TobyB-QLB/Z1013-Tang-Display/stl/README.md

# 3D-Gehäuse und Medien / 3D enclosure and media

[Deutsch](#deutsch) · [English](#english)

## Deutsch

Dieses Verzeichnis enthält die beiden STL-Dateien für das auf dem Foto gezeigte Z1013-Gehäuse sowie ein Foto und ein kurzes Video des aufgebauten Systems.

- [`Z1013_1.stl`](Z1013_1.stl) – erstes Gehäuseteil
- [`Z1013_2.stl`](Z1013_2.stl) – zweites Gehäuseteil
- [`z1013-tang-display.jpg`](z1013-tang-display.jpg) – für GitHub optimiertes Vorschaubild
- [`z1013-tang-display-innenaufbau.jpg`](z1013-tang-display-innenaufbau.jpg) – Innenansicht mit Display, Tang Nano 20K und Verkabelung
- [`IMG_0427.MOV`](IMG_0427.MOV) – Video des laufenden Aufbaus, etwa 40 MB

Die STL-Dateien werden in der Orientierung und mit den Einstellungen des jeweils verwendeten Slicers vorbereitet. Materialschrumpfung, Druckertoleranzen und die genaue Displaymontage können Anpassungen erfordern. Vor einem vollständigen Druck empfiehlt sich eine Kontrolle der Abmessungen und Steckerausschnitte im Slicer.

Das ursprüngliche HEIC-Foto bleibt lokal erhalten, wird aber nicht zusätzlich veröffentlicht, weil GitHub das daraus erzeugte JPEG direkt in der README anzeigen kann.

## English

This directory contains the two STL files for the enclosure shown in the photo, together with a photo and a short video of the assembled system.

- [`Z1013_1.stl`](Z1013_1.stl) – first enclosure part
- [`Z1013_2.stl`](Z1013_2.stl) – second enclosure part
- [`z1013-tang-display.jpg`](z1013-tang-display.jpg) – GitHub-optimized preview image
- [`z1013-tang-display-innenaufbau.jpg`](z1013-tang-display-innenaufbau.jpg) – internal view showing the display, Tang Nano 20K, and wiring
- [`IMG_0427.MOV`](IMG_0427.MOV) – video of the running system, approximately 40 MB

Prepare the STL orientation and print settings in the slicer used for your printer. Material shrinkage, printer tolerances, and the exact display mounting may require adjustments. Check dimensions and connector cutouts in the slicer before committing to a complete print.

The original HEIC photo remains in the local folder but is not published separately because GitHub can display the derived JPEG directly in the README.
