TobyB-QLB/Z1013-Tang-Display/stl/Z1013_2.stl

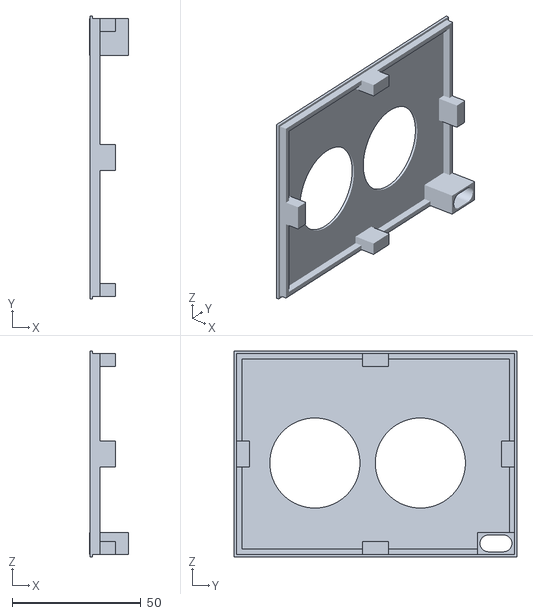
[picture p2: CAD file, 2026-10-25]
stl/Z1013_2.stl
15.0 x 110.0 x 80.0
