TobyB-QLB/Z1013-Tang-Display/stl/Z1013_1.stl

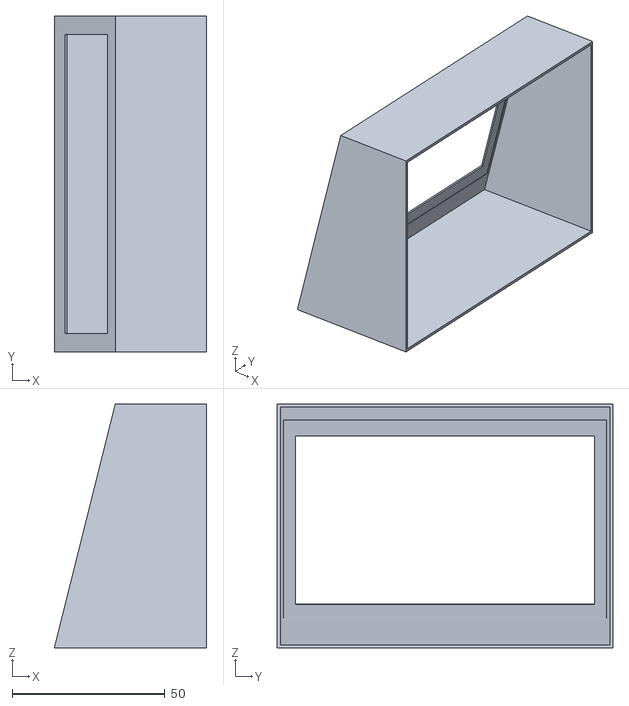
[picture p3: CAD file, 2026-10-25]
stl/Z1013_1.stl
50.0 x 110.0 x 80.0
