TobyB-QLB/Z1013-Tang-Display/stl/z1013-tang-display-innenaufbau.jpg

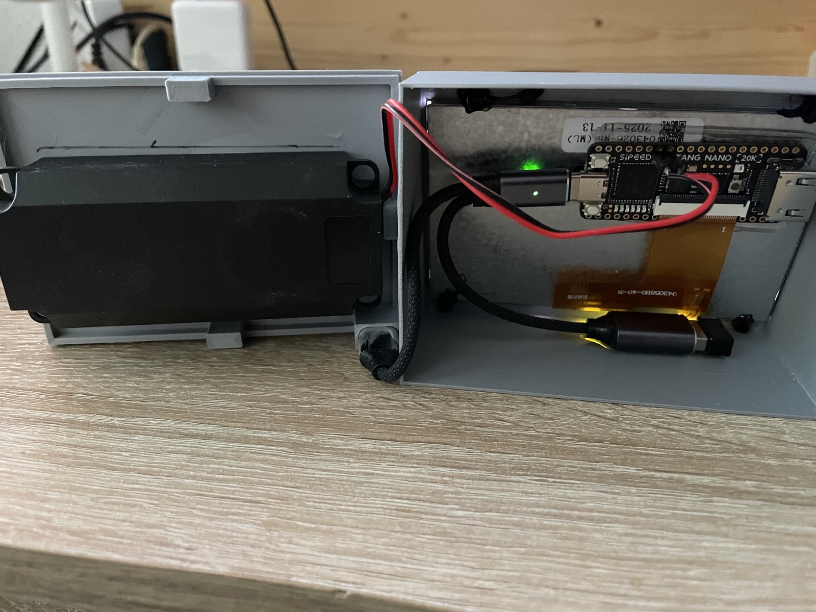
stl/z1013-tang-display-innenaufbau.jpg
