TobyB-QLB/Z1013-Tang-Display/src/color_ram.vhd

library IEEE;
use IEEE.STD_LOGIC_1164.ALL;
use IEEE.NUMERIC_STD.ALL;

-- 8 KiB dual-port colour attribute RAM.
--
-- Every byte corresponds one-to-one with a byte in the monochrome video RAM:
--   bits 3..0 = foreground colour
--   bits 7..4 = background colour
--
-- Port A is selected by the Z80 through the hidden colour-RAM bank. Port B is
-- read continuously in parallel with the original video RAM. The initial value
-- 0Fh means white foreground on black background.

entity color_ram is
    port (
        cpu_clk    : in  std_logic;
        cpu_addr   : in  std_logic_vector(12 downto 0);
        cpu_din    : in  std_logic_vector(7 downto 0);
        cpu_dout   : out std_logic_vector(7 downto 0);
        cpu_we     : in  std_logic;

        video_clk  : in  std_logic;
        video_addr : in  std_logic_vector(12 downto 0);
        video_dout : out std_logic_vector(7 downto 0)
    );
end entity color_ram;

-- Physical DPB blocks are inline: no dependency on another source file.
architecture gowin of color_ram is
 constant INITIAL_BYTE : natural := 15;

component DPB is
    GENERIC (
		BIT_WIDTH_0 : integer :=16; -- 1, 2, 4, 8, 16
		BIT_WIDTH_1 : integer :=16; -- 1, 2, 4, 8, 16
		READ_MODE0 : bit := '0'; -- 0: bypass mode; 1: pipeline mode
		READ_MODE1 : bit := '0'; -- 0: bypass mode; 1: pipeline mode
		WRITE_MODE0 : bit_vector := "00"; -- 00: normal mode; 01: write-through mode; 10: read-before-write mode
		WRITE_MODE1 : bit_vector := "00"; -- 00: normal mode; 01: write-through mode; 10: read-before-write mode
	    BLK_SEL_0 : bit_vector := "000";
	    BLK_SEL_1 : bit_vector := "000";
        RESET_MODE : string := "SYNC";--SYNC, ASYNC
		INIT_RAM_00 : bit_vector := X"0000000000000000000000000000000000000000000000000000000000000000";
		INIT_RAM_01 : bit_vector := X"0000000000000000000000000000000000000000000000000000000000000000";
		INIT_RAM_02 : bit_vector := X"0000000000000000000000000000000000000000000000000000000000000000";
		INIT_RAM_03 : bit_vector := X"0000000000000000000000000000000000000000000000000000000000000000";
		INIT_RAM_04 : bit_vector := X"0000000000000000000000000000000000000000000000000000000000000000";
		INIT_RAM_05 : bit_vector := X"0000000000000000000000000000000000000000000000000000000000000000";
		INIT_RAM_06 : bit_vector := X"0000000000000000000000000000000000000000000000000000000000000000";
		INIT_RAM_07 : bit_vector := X"0000000000000000000000000000000000000000000000000000000000000000";
		INIT_RAM_08 : bit_vector := X"0000000000000000000000000000000000000000000000000000000000000000";
		INIT_RAM_09 : bit_vector := X"0000000000000000000000000000000000000000000000000000000000000000";
		INIT_RAM_0A : bit_vector := X"0000000000000000000000000000000000000000000000000000000000000000";
		INIT_RAM_0B : bit_vector := X"0000000000000000000000000000000000000000000000000000000000000000";
		INIT_RAM_0C : bit_vector := X"0000000000000000000000000000000000000000000000000000000000000000";
		INIT_RAM_0D : bit_vector := X"0000000000000000000000000000000000000000000000000000000000000000";
		INIT_RAM_0E : bit_vector := X"0000000000000000000000000000000000000000000000000000000000000000";
		INIT_RAM_0F : bit_vector := X"0000000000000000000000000000000000000000000000000000000000000000";
		INIT_RAM_10 : bit_vector := X"0000000000000000000000000000000000000000000000000000000000000000";
		INIT_RAM_11 : bit_vector := X"0000000000000000000000000000000000000000000000000000000000000000";
		INIT_RAM_12 : bit_vector := X"0000000000000000000000000000000000000000000000000000000000000000";
		INIT_RAM_13 : bit_vector := X"0000000000000000000000000000000000000000000000000000000000000000";
		INIT_RAM_14 : bit_vector := X"0000000000000000000000000000000000000000000000000000000000000000";
		INIT_RAM_15 : bit_vector := X"0000000000000000000000000000000000000000000000000000000000000000";
		INIT_RAM_16 : bit_vector := X"0000000000000000000000000000000000000000000000000000000000000000";
		INIT_RAM_17 : bit_vector := X"0000000000000000000000000000000000000000000000000000000000000000";
		INIT_RAM_18 : bit_vector := X"0000000000000000000000000000000000000000000000000000000000000000";
		INIT_RAM_19 : bit_vector := X"0000000000000000000000000000000000000000000000000000000000000000";
		INIT_RAM_1A : bit_vector := X"0000000000000000000000000000000000000000000000000000000000000000";
		INIT_RAM_1B : bit_vector := X"0000000000000000000000000000000000000000000000000000000000000000";
		INIT_RAM_1C : bit_vector := X"0000000000000000000000000000000000000000000000000000000000000000";
		INIT_RAM_1D : bit_vector := X"0000000000000000000000000000000000000000000000000000000000000000";
		INIT_RAM_1E : bit_vector := X"0000000000000000000000000000000000000000000000000000000000000000";
		INIT_RAM_1F : bit_vector := X"0000000000000000000000000000000000000000000000000000000000000000";
		INIT_RAM_20 : bit_vector := X"0000000000000000000000000000000000000000000000000000000000000000";
		INIT_RAM_21 : bit_vector := X"0000000000000000000000000000000000000000000000000000000000000000";
		INIT_RAM_22 : bit_vector := X"0000000000000000000000000000000000000000000000000000000000000000";
		INIT_RAM_23 : bit_vector := X"0000000000000000000000000000000000000000000000000000000000000000";
		INIT_RAM_24 : bit_vector := X"0000000000000000000000000000000000000000000000000000000000000000";
		INIT_RAM_25 : bit_vector := X"0000000000000000000000000000000000000000000000000000000000000000";
		INIT_RAM_26 : bit_vector := X"0000000000000000000000000000000000000000000000000000000000000000";
		INIT_RAM_27 : bit_vector := X"0000000000000000000000000000000000000000000000000000000000000000";
		INIT_RAM_28 : bit_vector := X"0000000000000000000000000000000000000000000000000000000000000000";
		INIT_RAM_29 : bit_vector := X"0000000000000000000000000000000000000000000000000000000000000000";
		INIT_RAM_2A : bit_vector := X"0000000000000000000000000000000000000000000000000000000000000000";
		INIT_RAM_2B : bit_vector := X"0000000000000000000000000000000000000000000000000000000000000000";
		INIT_RAM_2C : bit_vector := X"0000000000000000000000000000000000000000000000000000000000000000";
		INIT_RAM_2D : bit_vector := X"0000000000000000000000000000000000000000000000000000000000000000";
		INIT_RAM_2E : bit_vector := X"0000000000000000000000000000000000000000000000000000000000000000";
		INIT_RAM_2F : bit_vector := X"0000000000000000000000000000000000000000000000000000000000000000";
		INIT_RAM_30 : bit_vector := X"0000000000000000000000000000000000000000000000000000000000000000";
		INIT_RAM_31 : bit_vector := X"0000000000000000000000000000000000000000000000000000000000000000";
		INIT_RAM_32 : bit_vector := X"0000000000000000000000000000000000000000000000000000000000000000";
		INIT_RAM_33 : bit_vector := X"0000000000000000000000000000000000000000000000000000000000000000";
		INIT_RAM_34 : bit_vector := X"0000000000000000000000000000000000000000000000000000000000000000";
		INIT_RAM_35 : bit_vector := X"0000000000000000000000000000000000000000000000000000000000000000";
		INIT_RAM_36 : bit_vector := X"0000000000000000000000000000000000000000000000000000000000000000";
		INIT_RAM_37 : bit_vector := X"0000000000000000000000000000000000000000000000000000000000000000";
		INIT_RAM_38 : bit_vector := X"0000000000000000000000000000000000000000000000000000000000000000";
		INIT_RAM_39 : bit_vector := X"0000000000000000000000000000000000000000000000000000000000000000";
		INIT_RAM_3A : bit_vector := X"0000000000000000000000000000000000000000000000000000000000000000";
		INIT_RAM_3B : bit_vector := X"0000000000000000000000000000000000000000000000000000000000000000";
		INIT_RAM_3C : bit_vector := X"0000000000000000000000000000000000000000000000000000000000000000";
		INIT_RAM_3D : bit_vector := X"0000000000000000000000000000000000000000000000000000000000000000";
		INIT_RAM_3E : bit_vector := X"0000000000000000000000000000000000000000000000000000000000000000";
		INIT_RAM_3F : bit_vector := X"0000000000000000000000000000000000000000000000000000000000000000"
    );
    PORT (
		DOA,DOB : out std_logic_vector(15 downto 0);
		CLKA,CLKB, CEA,CEB,OCEA,OCEB,RESETA,RESETB,WREA,WREB : in std_logic;
		ADA,ADB : in std_logic_vector(13 downto 0);
		BLKSELA, BLKSELB : in std_logic_vector(2 downto 0);
		DIA,DIB : in std_logic_vector(15 downto 0)
    );
end component;
 type data_array_t is array(0 to 3) of std_logic_vector(15 downto 0);
 signal cpu_data,video_data : data_array_t;
 signal cpu_bank,video_bank : unsigned(1 downto 0) := (others=>'0');
 signal cpu_input : std_logic_vector(15 downto 0);
 signal cpu_block,video_block : std_logic_vector(2 downto 0);
 signal cpu_address,video_address : std_logic_vector(13 downto 0);
 function init_chunk return bit_vector is
  variable chunk:bit_vector(255 downto 0);
 begin
  for i in 0 to 31 loop
   chunk(i*8+7 downto i*8):=to_bitvector(std_logic_vector(to_unsigned(INITIAL_BYTE,8)));
  end loop;
  return chunk;
 end;
 constant INITIAL_CHUNK : bit_vector(255 downto 0) := init_chunk;
begin
 cpu_input <= x"00" & cpu_din;
 cpu_block <= "0" & cpu_addr(12 downto 11);
 video_block <= "0" & video_addr(12 downto 11);
 cpu_address <= cpu_addr(10 downto 0) & "000";
 video_address <= video_addr(10 downto 0) & "000";
 process(cpu_clk) begin
  if rising_edge(cpu_clk) then cpu_bank<=unsigned(cpu_addr(12 downto 11));end if;
 end process;
 process(video_clk) begin
  if rising_edge(video_clk) then video_bank<=unsigned(video_addr(12 downto 11));end if;
 end process;
 cpu_dout<=cpu_data(to_integer(cpu_bank))(7 downto 0);
 video_dout<=video_data(to_integer(video_bank))(7 downto 0);
 banks:for i in 0 to 3 generate
  ram:DPB generic map(
   BIT_WIDTH_0=>8, BIT_WIDTH_1=>8,
   READ_MODE0=>'0', READ_MODE1=>'0',
   WRITE_MODE0=>"01", WRITE_MODE1=>"00",
   BLK_SEL_0=>to_bitvector(std_logic_vector(to_unsigned(i,3))),
   BLK_SEL_1=>to_bitvector(std_logic_vector(to_unsigned(i,3))),
   RESET_MODE=>"SYNC",
   INIT_RAM_00=>INITIAL_CHUNK,
   INIT_RAM_01=>INITIAL_CHUNK,
   INIT_RAM_02=>INITIAL_CHUNK,
   INIT_RAM_03=>INITIAL_CHUNK,
   INIT_RAM_04=>INITIAL_CHUNK,
   INIT_RAM_05=>INITIAL_CHUNK,
   INIT_RAM_06=>INITIAL_CHUNK,
   INIT_RAM_07=>INITIAL_CHUNK,
   INIT_RAM_08=>INITIAL_CHUNK,
   INIT_RAM_09=>INITIAL_CHUNK,
   INIT_RAM_0A=>INITIAL_CHUNK,
   INIT_RAM_0B=>INITIAL_CHUNK,
   INIT_RAM_0C=>INITIAL_CHUNK,
   INIT_RAM_0D=>INITIAL_CHUNK,
   INIT_RAM_0E=>INITIAL_CHUNK,
   INIT_RAM_0F=>INITIAL_CHUNK,
   INIT_RAM_10=>INITIAL_CHUNK,
   INIT_RAM_11=>INITIAL_CHUNK,
   INIT_RAM_12=>INITIAL_CHUNK,
   INIT_RAM_13=>INITIAL_CHUNK,
   INIT_RAM_14=>INITIAL_CHUNK,
   INIT_RAM_15=>INITIAL_CHUNK,
   INIT_RAM_16=>INITIAL_CHUNK,
   INIT_RAM_17=>INITIAL_CHUNK,
   INIT_RAM_18=>INITIAL_CHUNK,
   INIT_RAM_19=>INITIAL_CHUNK,
   INIT_RAM_1A=>INITIAL_CHUNK,
   INIT_RAM_1B=>INITIAL_CHUNK,
   INIT_RAM_1C=>INITIAL_CHUNK,
   INIT_RAM_1D=>INITIAL_CHUNK,
   INIT_RAM_1E=>INITIAL_CHUNK,
   INIT_RAM_1F=>INITIAL_CHUNK,
   INIT_RAM_20=>INITIAL_CHUNK,
   INIT_RAM_21=>INITIAL_CHUNK,
   INIT_RAM_22=>INITIAL_CHUNK,
   INIT_RAM_23=>INITIAL_CHUNK,
   INIT_RAM_24=>INITIAL_CHUNK,
   INIT_RAM_25=>INITIAL_CHUNK,
   INIT_RAM_26=>INITIAL_CHUNK,
   INIT_RAM_27=>INITIAL_CHUNK,
   INIT_RAM_28=>INITIAL_CHUNK,
   INIT_RAM_29=>INITIAL_CHUNK,
   INIT_RAM_2A=>INITIAL_CHUNK,
   INIT_RAM_2B=>INITIAL_CHUNK,
   INIT_RAM_2C=>INITIAL_CHUNK,
   INIT_RAM_2D=>INITIAL_CHUNK,
   INIT_RAM_2E=>INITIAL_CHUNK,
   INIT_RAM_2F=>INITIAL_CHUNK,
   INIT_RAM_30=>INITIAL_CHUNK,
   INIT_RAM_31=>INITIAL_CHUNK,
   INIT_RAM_32=>INITIAL_CHUNK,
   INIT_RAM_33=>INITIAL_CHUNK,
   INIT_RAM_34=>INITIAL_CHUNK,
   INIT_RAM_35=>INITIAL_CHUNK,
   INIT_RAM_36=>INITIAL_CHUNK,
   INIT_RAM_37=>INITIAL_CHUNK,
   INIT_RAM_38=>INITIAL_CHUNK,
   INIT_RAM_39=>INITIAL_CHUNK,
   INIT_RAM_3A=>INITIAL_CHUNK,
   INIT_RAM_3B=>INITIAL_CHUNK,
   INIT_RAM_3C=>INITIAL_CHUNK,
   INIT_RAM_3D=>INITIAL_CHUNK,
   INIT_RAM_3E=>INITIAL_CHUNK,
   INIT_RAM_3F=>INITIAL_CHUNK
  ) port map(
   DOA=>cpu_data(i),DOB=>video_data(i),
   DIA=>cpu_input,DIB=>x"0000",
   BLKSELA=>cpu_block,BLKSELB=>video_block,
   ADA=>cpu_address,ADB=>video_address,
   WREA=>cpu_we,WREB=>'0',CLKA=>cpu_clk,CLKB=>video_clk,
   CEA=>'1',CEB=>'1',OCEA=>'1',OCEB=>'1',RESETA=>'0',RESETB=>'0');
 end generate;
end architecture;
