TobyB-QLB/Z1013-Tang-Display/src/font_rom.vhd

library IEEE;
use IEEE.STD_LOGIC_1164.ALL;
use IEEE.NUMERIC_STD.ALL;

entity font_rom is
    port (
        char_code : in  unsigned(7 downto 0);
        char_row  : in  unsigned(2 downto 0);
        font_data : out std_logic_vector(7 downto 0)
    );
end entity font_rom;

architecture Behavioral of font_rom is

    -- Originaler Z1013-Zeichengenerator:
    -- 256 Zeichen x 8 Zeilen = 2048 Byte.
    -- Quelle: erster 2048-Byte-Block von Z1013.bin.
    type font_array is array (0 to 2047) of std_logic_vector(7 downto 0);
    constant FONT : font_array := (
           0 => x"FF",
           1 => x"FF",
           2 => x"FF",
           3 => x"FF",
           4 => x"FF",
           5 => x"FF",
           6 => x"FF",
           7 => x"FF",
           8 => x"FF",
           9 => x"FF",
          10 => x"FF",
          11 => x"FF",
          12 => x"FF",
          13 => x"FF",
          14 => x"FF",
          15 => x"FF",
          16 => x"FF",
          17 => x"FF",
          18 => x"FF",
          19 => x"FF",
          20 => x"FF",
          21 => x"FF",
          22 => x"FF",
          23 => x"FF",
          24 => x"FF",
          25 => x"FF",
          26 => x"FF",
          27 => x"FF",
          28 => x"FF",
          29 => x"FF",
          30 => x"FF",
          31 => x"FF",
          32 => x"FF",
          33 => x"FF",
          34 => x"FF",
          35 => x"FF",
          36 => x"FF",
          37 => x"FF",
          38 => x"FF",
          39 => x"FF",
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
        2042 => x"FF",
        2043 => x"FF",
        2044 => x"FF",
        2045 => x"FF",
        2046 => x"FF",
        2047 => x"FF"
    );

begin

    font_data <= FONT(
        to_integer(char_code) * 8 +
        to_integer(char_row)
    );

end architecture Behavioral;
