TobyB-QLB/Z1013-Tang-Display/src/gowin_rom/gowin_z1013_rom.vhd

--Copyright (C)2014-2026 Gowin Semiconductor Corporation.
--All rights reserved.
--File Title: Z1013 8 KiB boot ROM for recovered COMMAND.COM and IO.SYS
--Tool Version: V1.9.12.03
--IP Version: 1.0
--Part Number: GW2AR-LV18QN88C8/I7
--Device: GW2AR-18
--Program at 0000h:
--    copy COMMAND.COM from ROM 0100h to RAM F000h
--    copy IO.SYS from ROM 1100h to RAM E300h
--    copy a RAM trampoline to E200h
--Program at E200h:
--    OUT (08h),A removes the ROM overlay and enables all 64 KiB RAM
--    jump to the original monitor entry at F280h
--STEP 18 corrected directory test:
--    copy the reconstructed directory sector from ROM 1A00h to RAM DC00h
--    EA00h returns the directory for sector 1 and an empty sector thereafter
--COMMAND.COM, FILE.BIN and the original @DD directory parser remain unchanged.

library IEEE;
use IEEE.std_logic_1164.all;

entity Gowin_Z1013_ROM is
    port (
        dout: out std_logic_vector(7 downto 0);
        clk: in std_logic;
        oce: in std_logic;
        ce: in std_logic;
        reset: in std_logic;
        ad: in std_logic_vector(12 downto 0)
    );
end Gowin_Z1013_ROM;

architecture Behavioral of Gowin_Z1013_ROM is

    signal prom_ad_i: std_logic_vector(13 downto 0);
    signal prom_bank_0_do: std_logic_vector(31 downto 0);
    signal prom_bank_1_do: std_logic_vector(31 downto 0);
    signal prom_bank_2_do: std_logic_vector(31 downto 0);
    signal prom_bank_3_do: std_logic_vector(31 downto 0);

    --component declaration
    component pROM
        generic (
            READ_MODE: in bit :='0';
            BIT_WIDTH: in integer := 1;
            RESET_MODE: in string := "SYNC";
            INIT_RAM_00: in bit_vector := X"0000000000000000000000000000000000000000000000000000000000000000";
            INIT_RAM_01: in bit_vector := X"0000000000000000000000000000000000000000000000000000000000000000";
            INIT_RAM_02: in bit_vector := X"0000000000000000000000000000000000000000000000000000000000000000";
            INIT_RAM_03: in bit_vector := X"0000000000000000000000000000000000000000000000000000000000000000";
            INIT_RAM_04: in bit_vector := X"0000000000000000000000000000000000000000000000000000000000000000";
            INIT_RAM_05: in bit_vector := X"0000000000000000000000000000000000000000000000000000000000000000";
            INIT_RAM_06: in bit_vector := X"0000000000000000000000000000000000000000000000000000000000000000";
            INIT_RAM_07: in bit_vector := X"0000000000000000000000000000000000000000000000000000000000000000";
            INIT_RAM_08: in bit_vector := X"0000000000000000000000000000000000000000000000000000000000000000";
            INIT_RAM_09: in bit_vector := X"0000000000000000000000000000000000000000000000000000000000000000";
            INIT_RAM_0A: in bit_vector := X"0000000000000000000000000000000000000000000000000000000000000000";
            INIT_RAM_0B: in bit_vector := X"0000000000000000000000000000000000000000000000000000000000000000";
            INIT_RAM_0C: in bit_vector := X"0000000000000000000000000000000000000000000000000000000000000000";
            INIT_RAM_0D: in bit_vector := X"0000000000000000000000000000000000000000000000000000000000000000";
            INIT_RAM_0E: in bit_vector := X"0000000000000000000000000000000000000000000000000000000000000000";
            INIT_RAM_0F: in bit_vector := X"0000000000000000000000000000000000000000000000000000000000000000";
            INIT_RAM_10: in bit_vector := X"0000000000000000000000000000000000000000000000000000000000000000";
            INIT_RAM_11: in bit_vector := X"0000000000000000000000000000000000000000000000000000000000000000";
            INIT_RAM_12: in bit_vector := X"0000000000000000000000000000000000000000000000000000000000000000";
            INIT_RAM_13: in bit_vector := X"0000000000000000000000000000000000000000000000000000000000000000";
            INIT_RAM_14: in bit_vector := X"0000000000000000000000000000000000000000000000000000000000000000";
            INIT_RAM_15: in bit_vector := X"0000000000000000000000000000000000000000000000000000000000000000";
            INIT_RAM_16: in bit_vector := X"0000000000000000000000000000000000000000000000000000000000000000";
            INIT_RAM_17: in bit_vector := X"0000000000000000000000000000000000000000000000000000000000000000";
            INIT_RAM_18: in bit_vector := X"0000000000000000000000000000000000000000000000000000000000000000";
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
            INIT_RAM_3C => X"2820FEEBBA3AF910E9D1CD237E0806EBB221EB8232AFE9DACDF6200DFE64281B",
            INIT_RAM_3D => X"21F910E9D1CD203E060602180206F910E9D1CD237E0306EBBA21E9D1CD2E3E15",
            INIT_RAM_3E => X"3EE9D1CD203EC9B7EB82323CEB823AD8DACDEBB021D8DACDEBAE21D8DACDEBAC",
            INIT_RAM_3F => X"0000000000000000000000000000000000000000000000C937E9FDC3E9D1CD20"
        )
        port map (
            DO => prom_bank_3_do,
            CLK => clk,
            OCE => oce,
            CE => ce,
            RESET => reset,
            AD => prom_ad_i
        );

end Behavioral; --Gowin_Z1013_ROM
